codage23/projet_robocup_2024/README.md

Bonjours nous somme la Sostra-team.

Nous avons imaginé et réalisé le CuboBot dans le but de participer a un concourt nommé RoboCup.

Ce projet se divise en 6 modules soit: le Convoyeur, le Distributeur, le Portique de détection, le Bras articulé , l'afficheur Led ainsi que le module Son.
L'ensemble, est coordonné par le module Master.

Le but de ce concept est de trier des forme tel que des cubes celons leurs couleurs. 

Pour ce faire le distributeur envoie les cubes sur le convoyeur, qui les emmènent jusqu'au portique de détection de couleur.
Une fois la couleur détectée, l'information est transmise au bras, ensuite celle ci est annoncée à haute voix grâce au module son, de plus elle s'affiche sur le panneau led, tout ça dans le but de la révéler au publique.

Ceci fait le convoyeur emmène le cube jusqu'au détecteur de fin de course, placé au bout du convoyeur c'est lui qui donnera le signal au bras qu'il peut enfin venir chercher le cube et le ranger dans la boite prévue a cet effet.

La boucle recommence par le distributeur...
