codage23/projet_robocup_2024/organigramme/legende.odt

Légende :

// id 11 : moteur du convoyeur («D»emarrage «S»top)

// id 12 : IR du convoyeur («A»bsent «P»resent)

// id 13 : master

// id 14 : distributeur de cube («L»iberer)

// id 15 : IR du portique de detection de la couleur

// id 16 : detection de la couleur du cube avec le portique n°1 («R»ed «G»reen «B»lue «Y»ellow)

// id 17 : panneau d'affichage («R»ed «G»reen «B»lue «Y»ellow «E»xtinction)

// id 18 : bras articule (Red Green Blue Yellow)

// id 19 : detection de la couleur du cube avec le portique n°2 (Red Green Blue Yellow)
