codage23/projet_robocup_2024/master_modules/schema electrique master robocup 2024.pdf

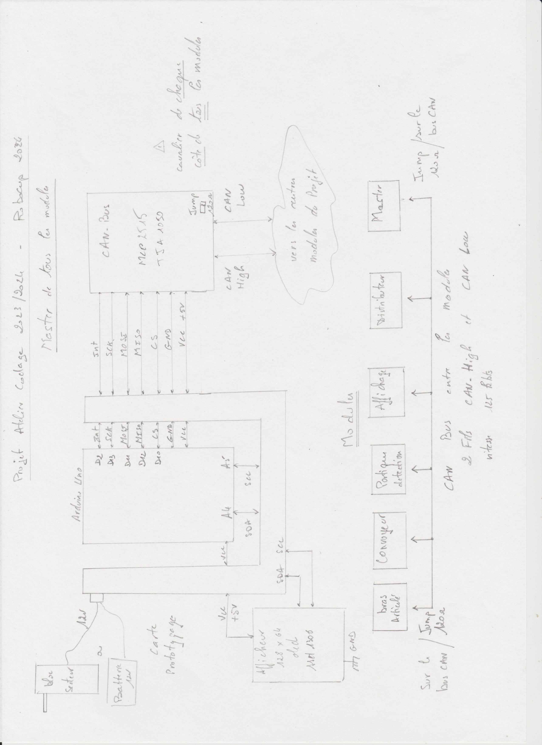
[picture p1: page 1]
