codage23/projet_robocup_2024/module_affichage/schema electrique afficheur robocup 2024.pdf

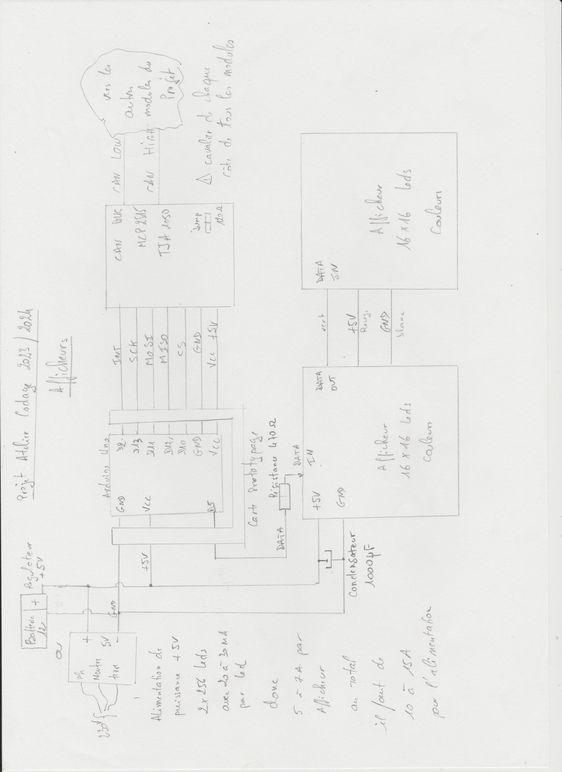
[picture p2: page 1]
