codage23/projet_robocup_2024/module_affichage/schema principe afficheur robocup 2024.pdf

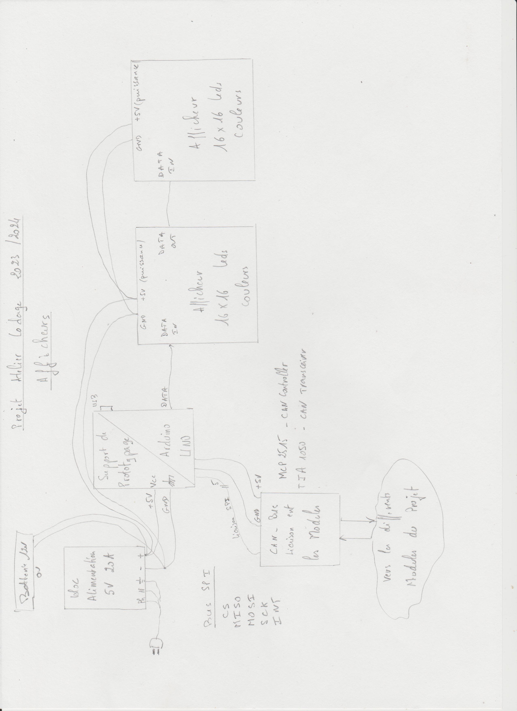
[picture p3: page 1]
