codage23/projet_robocup_2024/module_bras/schema electrique bras articule robocup 2024.pdf

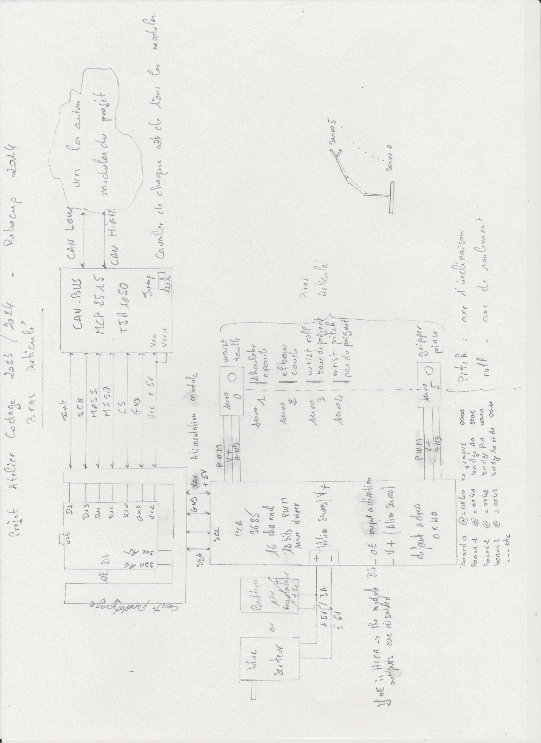
[picture p4: page 1]
