codage23/projet_robocup_2024/module_convoyeur/schema electrique convoyeur robocup 2024.pdf

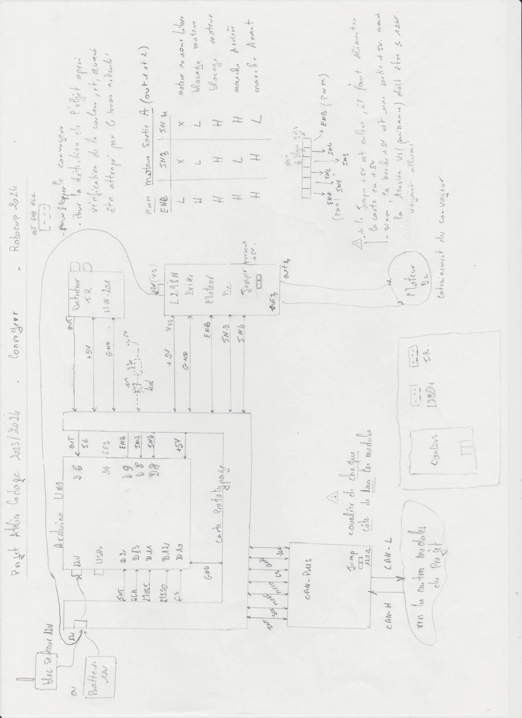
[picture p5: page 1]
