codage23/projet_robocup_2024/module_convoyeur/schema principe convoyeur robocup 2024.pdf

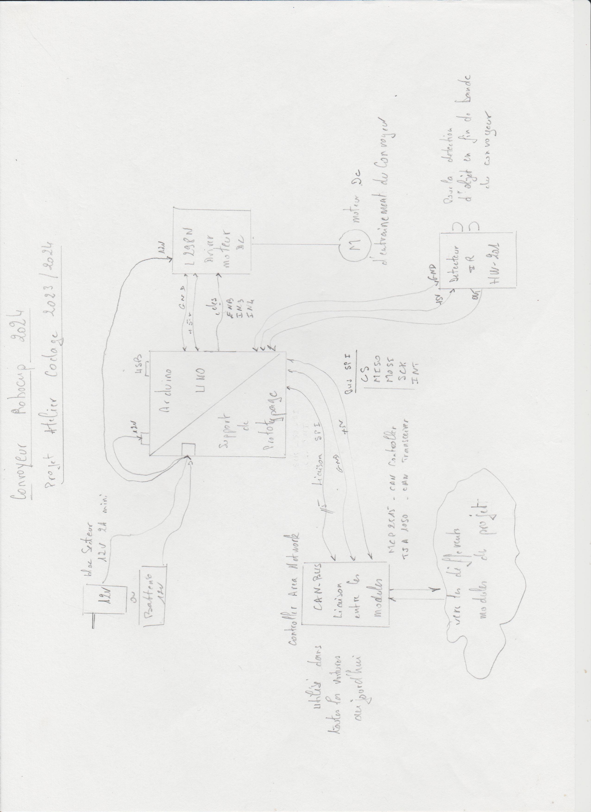
[picture p6: page 1]
