codage23/projet_robocup_2024/module_portique/schema electrique portique de detection robocup 2024.pdf

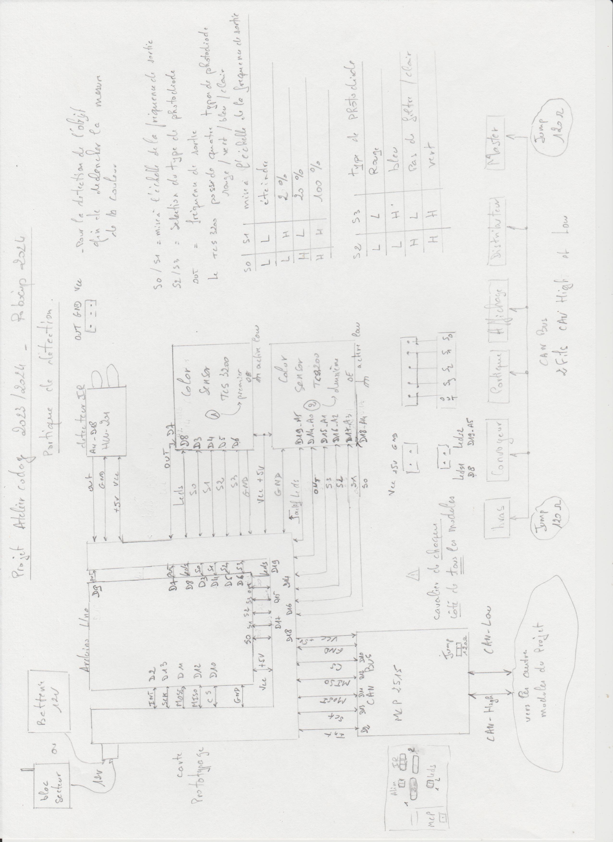
[picture p7: page 1]
