codage23/projet_robocup_2024/presentation projet/map mind projet robocup 2024 2025.pdf

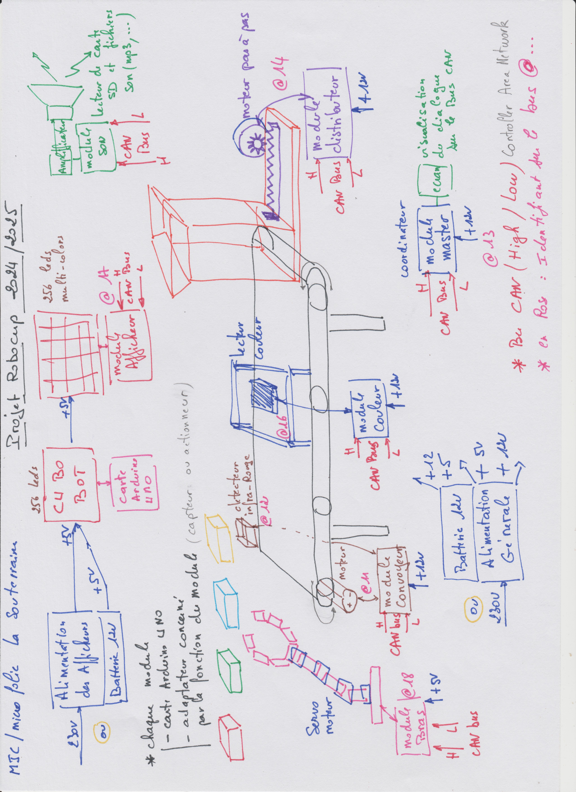
[picture p8: page 1]
