codage23/projet_robocup_2024/presentation projet/carte mentale.pdf

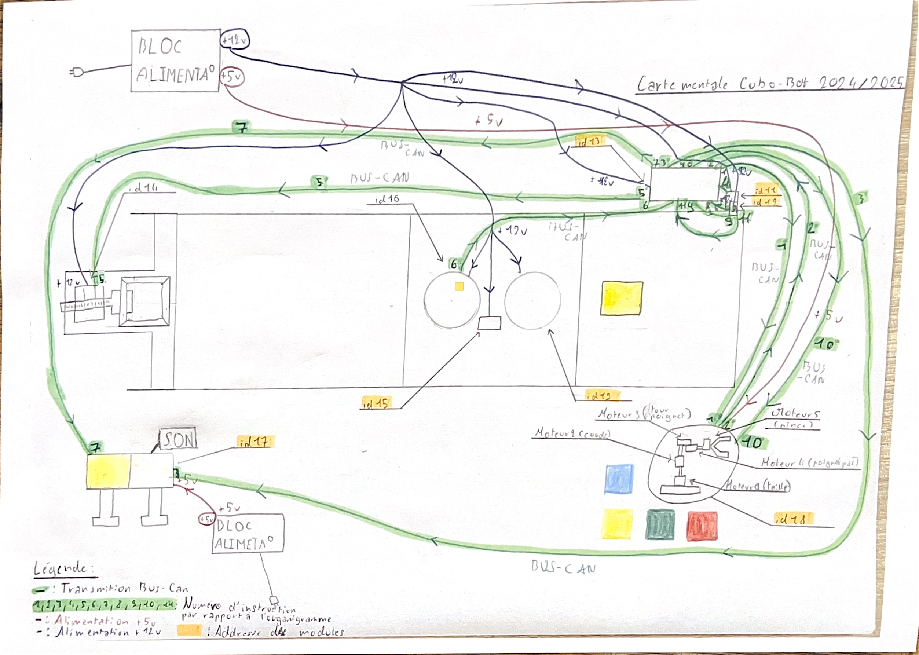
[picture p9: page 1]
