codage23/projet_robocup_2024/organigramme/organigramme.pdf

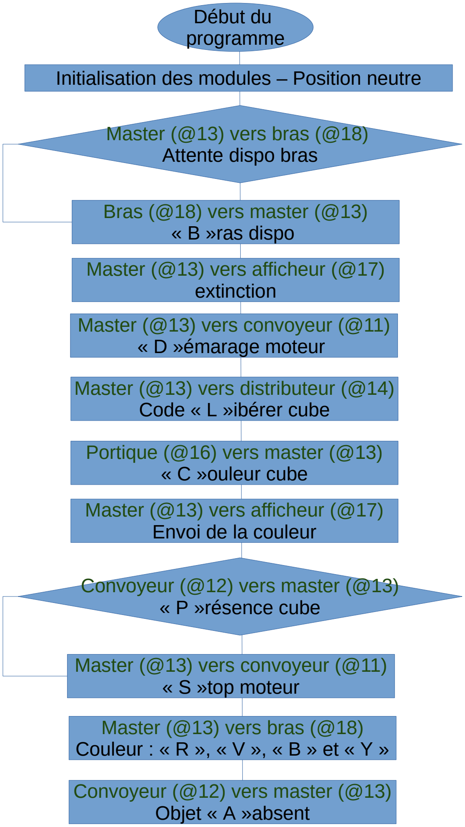
[picture p10: figure]
Début du programme; Bras (@18) vers master (@13) « B »ras dispo; Master (@13) vers distributeur (@14) Code « L »ibérer cube; Portique (@16) vers master (@13) « C »ouleur cube; Convoyeur (@12) vers master (@13) « P »résence cube; Master (@13) vers convoyeur (@11) « S »top moteur; Master (@13) vers afficheur (@17) extinction; Master (@13) vers bras (@18) Couleur : « R », « V », « B » et « Y »; Master (@13) vers convoyeur (@11) « D »émarage moteur; Convoyeur (@12) vers master (@13) Objet « A »absent; Master (@13) vers bras (@18) Attente dispo bras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

Initialisation des modules – Position neutre
