codage23/projet_robocup_2024/module_distributeur/schema electrique distributeur avec stepper.pdf

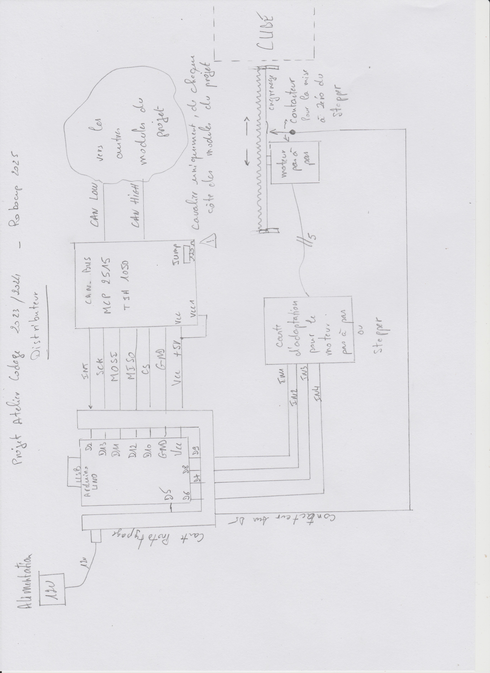
[picture p11: page 1]
