codage23/projet_robocup_2024/module_distributeur/schema principe distributeur avec stepper.pdf

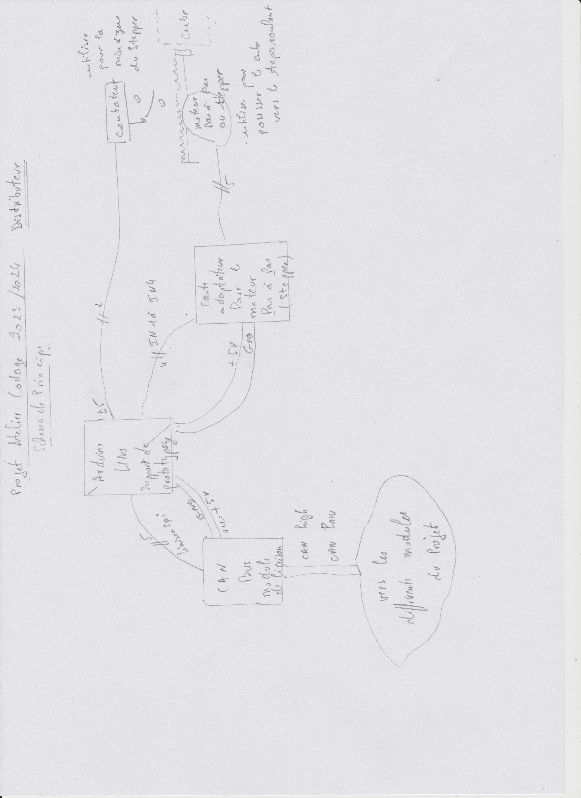
[picture p12: page 1]
