codage23/projet_robocup_2024/module_distributeur/robocup 2024 schema electrique module distributeur.pdf

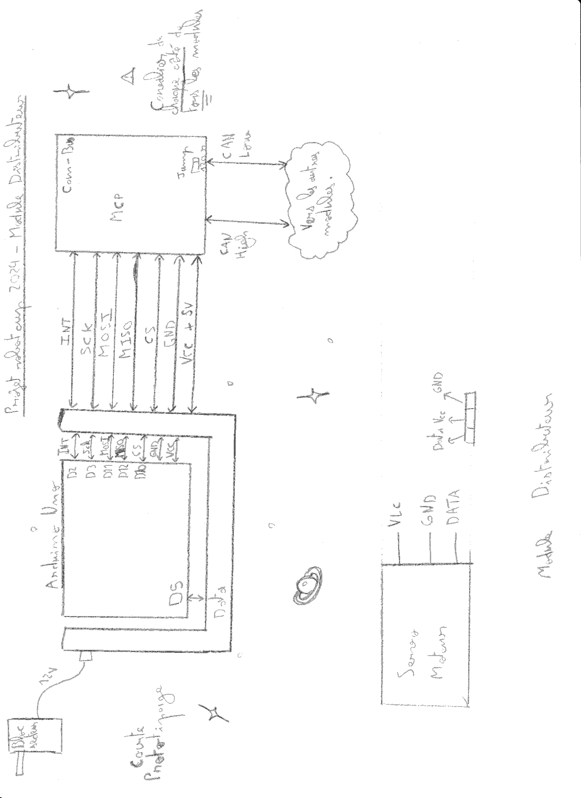
[picture p13: page 1]
