codage23/projet_robocup_2024/module_portique/schema principe portique de detection robocup 2024.pdf

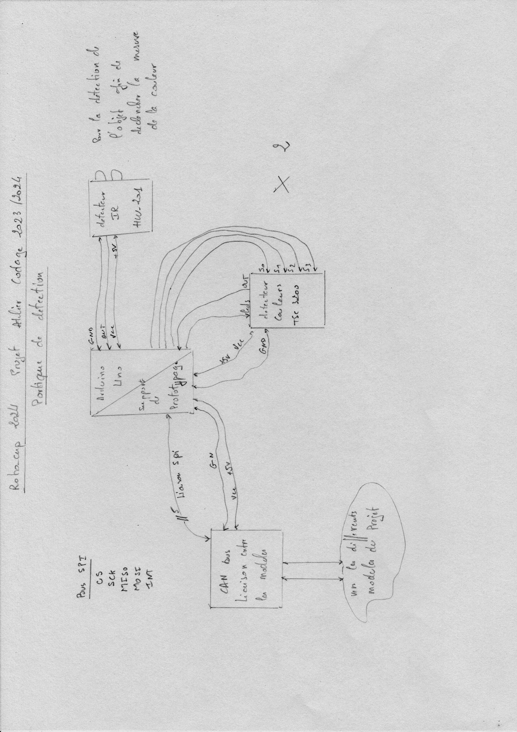
[picture p14: page 1]
