codage23/projet_robocup_2024/module_son/Schematic_Son_cubobot_2025-01-29.pdf

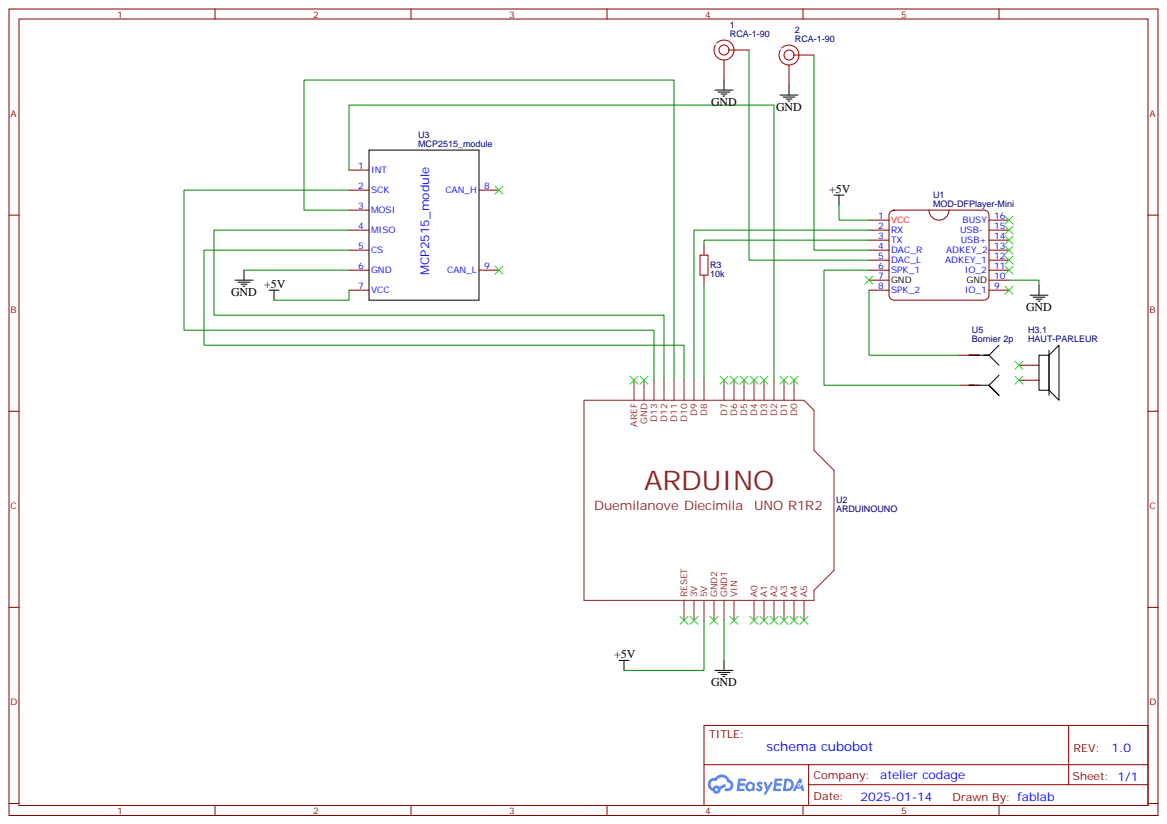
[picture p15: page 1]

MOD-DFPlayer-Mini
GND 10 IO_2 11 ADKEY_1 12 ADKEY_2 13 USB+ 14 USB- 15 BUSY 16
