codage23/projet_robocup_2024/module_convoyeur/convoyeur_arduino/convoyeur_arduino.ino

/***************************************************************
    projet robocup 2024
    convoyeur
    mjc fablab atelier codage 2023 2024
    https://passionelectronique.fr/tutoriel-l298n/
    https://tutorial45.com/mcp2515-arduino-project-can-arduino/
    https://github.com/sandeepmistry/arduino-CAN/tree/master
***************************************************************/

//=============================
// inclusion des bibliothèques
//=============================
#include <SPI.h>  // pour la bibliothèque CAN
#include <CAN.h>
#include "variables.h"  // fichier variables

//======================
// sensor IR infra rouge
//======================
bool sensorIR() {
  bool sensorStatus = digitalRead(IRSensor);  // read IRsensor
  return sensorStatus;
}

//======
// setup
//======
void setup() {
  Serial.begin(SERIAL_BAUD);
  Serial.println();
  Serial.println("Demarrage du convoyeur avec le sensor ir");

  // Configuration des pins de l'Arduino en "sortie" pour le shield L298N - gestion du moteur
  pinMode(borneENB, OUTPUT);
  pinMode(borneIN3, OUTPUT);
  pinMode(borneIN4, OUTPUT);

  // sensor ir infra rouge
  pinMode(IRSensor, INPUT);  // IR Sensor pin INPUT
  pinMode(LED, OUTPUT);      // LED Pin Output

  // start the CAN bus at 125 kbps
  if (!CAN.begin(125E3)) {
    Serial.println("Starting CAN failed!");
    while (1)
      ;
  }

  // register the receive callback - interruption des l'arrivee d'un message sur le bus can
  CAN.onReceive(onReceive);
}

//=========================================
// Fonction configurerSensDeRotationPontB()
// Definit le sens de rotation du moteur
//=========================================
void configurerSensDeRotationPontB(bool sensDeRotation) {
  if (sensDeRotation == MARCHE_AVANT) {
    // L298N en "marche avant", Selon sa table de verite
    digitalWrite(borneIN3, HIGH);  // IN3 niveau haut
    digitalWrite(borneIN4, LOW);   // IN4 niveau bas
  }
  if (sensDeRotation == MARCHE_ARRIERE) {
    // L298N en "marche avant", Selon sa table de verite
    digitalWrite(borneIN3, LOW);   // IN3 niveau bas
    digitalWrite(borneIN4, HIGH);  // IN4 niveau haut
  }
}

//=========================================================================
// Fonction changeVitesseMoteurPontB()
// Change la vitesse de rotation du moteur (valeur comprise entre 0 et 255)
//=========================================================================
void changeVitesseMoteurPontB(int nouvelleVitesse) {
  // signal PWM rapport cyclique "nouvelleVitesse"
  analogWrite(borneENB, nouvelleVitesse);
}

//==========================
//  CAN reception suite irq
//==========================
void onReceive(int packetSize) {
  while (CAN.available()) {
    caractere = (char)CAN.read();  // lecture du bus can dans la variable caractere
    id = CAN.packetId();           // id du message can  dans la variable id
  }
}

//======
// loop
//======
void loop() {
//====================================
// convoyeur avec CAN bus et le master
//====================================
#if CANBUS
  // demarrage progessif - une seule fois
  if (marche) {
    configurerSensDeRotationPontB(MARCHE_AVANT);  //sens de rotation du moteur en "marche avant"
    // depart progresif du moteur, vitesse maxi 255
    for (vitesse = vitesseMinimale; vitesse < vitesseMaximale; vitesse++) {
      changeVitesseMoteurPontB(vitesse);  // vitesse moteur avec signal PWM
      delay(delaiChangementVitesse);
    }
    marche = 0;  // pour avoir un seul demarrage progessif
  }

  // test la presence d'un objet avec le detecteur ir
  if ((sensorIR() == 0) and (presentAbsent == 0)) {  // objet present
    digitalWrite(LED, HIGH);                         // LED High
    presentAbsent = 1;                               // objet present
    CAN.beginPacket(0x12);                           // id 0x12 pour le detecteur ir du convoyeur
    CAN.write('P');                                  // envoi objet present P
    CAN.endPacket();                                 // envoi sur le bus can
    if (debug) {
      Serial.println("Sending packet objet present");
    }
  }

  if ((sensorIR() == 1) and (presentAbsent == 1)) {  // objet absent
    digitalWrite(LED, LOW);                          // LED LOW
    presentAbsent = 0;                               // objet absent
    CAN.beginPacket(0x12);                           // id 0x12 pour le detecteur ir du convoyeur
    CAN.write('A');                                  // envoi objet absent A
    CAN.endPacket();                                 // envoi sur le bus can
    if (debug) {
      Serial.println("Sending packet objet absent");
    }
  }

  if (caractere == 'S' and id == 0x11) {         // reception commande S du master id 0x11
    changeVitesseMoteurPontB(0);                 // arret moteur - vitesse nul
    caractere = '0';                             // effacement du caratere apres lecture
    id = 0x0;                                    // effacement de la variable id apres lecture
  }
  if (caractere == 'D' and id == 0x11) {         // reception commande D du master  id 0x11
    marche = 1;                                  // pour valider un nouveau demarrage car l'objet n'est plus present
    caractere = '0';                             // effacement du caratere apres lecture
    id = 0x0;                                    // effacement de la variable id apres lecture
  }
#endif

//====================================
// convoyeur autonome - sans le master
//====================================
#if AUTONOME
  // demarrage progessif du moteur une seule fois
  if (marche) {
    //sens de rotation du moteur en "marche avant"
    configurerSensDeRotationPontB(MARCHE_AVANT);
    // depart progresif du moteur, vitesse maxi 255
    for (vitesse = vitesseMinimale; vitesse < vitesseMaximale; vitesse++) {
      changeVitesseMoteurPontB(vitesse);  // vitesse moteur avec signal PWM
      delay(delaiChangementVitesse);
    }
    marche = 0;  // pour avoir un seul demarrage progessif
  }
  // Check if the pin high or not IRsensor
  if (sensorIR() == 1) {      // objet absent
    digitalWrite(LED, LOW);   // LED LOW
    if (objetPresent == 1) {  //  pour valider un nouveau demarrage des que l'objet n'est plus present
      marche = 1;
    }
    objetPresent = 0;  // pas d'objet 0
    if (debug) {
      Serial.println("objet absent");
    }
  }
  if (sensorIR() == 0) {      // objet present
    digitalWrite(LED, HIGH);  // LED High
    // arret moteur
    changeVitesseMoteurPontB(0);  // vitesse nul
    objetPresent = 1;             // objet present 1
    if (debug) {
      Serial.println("objet present");
    }
  }
#endif

//====================================
// convoyeur test - sans le master
//====================================
#if TEST
  //avant
  //sens de rotation du moteur en "marche avant"
  configurerSensDeRotationPontB(MARCHE_AVANT);
  // depart progresif du moteur, vitesse maxi 255
  for (vitesse = vitesseMinimale; vitesse < vitesseMaximale; vitesse++) {
    changeVitesseMoteurPontB(vitesse);  // vitesse moteur avec signal PWM
    delay(delaiChangementVitesse);
  }
  delay(10000);
  // deceleration progressive
  for (vitesse = vitesseMaximale; vitesse > vitesseMinimale; vitesse--) {
    changeVitesseMoteurPontB(vitesse);  // vitesse moteur avec signal PWM
    delay(delaiChangementVitesse);
  }
  // arret moteur
  changeVitesseMoteurPontB(0);
  delay(1000);
  //arriere
  //sens de rotation du moteur en "marche arriere"
  configurerSensDeRotationPontB(MARCHE_ARRIERE);
  //depart progresif du moteur, vitesse maxi 255
  for (vitesse = vitesseMinimale; vitesse < vitesseMaximale; vitesse++) {
    changeVitesseMoteurPontB(vitesse);  // vitesse moteur avec signal PWM
    delay(delaiChangementVitesse);
  }
  delay(10000);
  // deceleration progressive
  for (vitesse = vitesseMaximale; vitesse > vitesseMinimale; vitesse--) {
    changeVitesseMoteurPontB(vitesse);  // vitesse moteur avec signal PWM
    delay(delaiChangementVitesse);
  }
  // arret moteur
  changeVitesseMoteurPontB(0);
  delay(1000);
#endif
}
