codage23/projet_robocup_2024/(commit log)

2023-12-15 programme convoyeur propre et master seulement la partie convoyeur
2024-01-24 module portique pour la detection de couleurs
2024-02-07 master et portique , ajout de nouvelles fonctions
2024-03-16 mise à jour du deplacement du bras et ajout du servo moteur pour le distributeur
2024-03-19 debut reglage des servos du bras
2024-03-24 distributeur avec servotimer2 et milli - bras avec reglages de chaque servo
2024-03-26 module afficheur prise en compte des couleurs et affichage de la couleur sur les deux panneaux
2024-03-28 reglages disstributeur temps de fonctionnement du servo
2024-03-28 module afficheurs , la memoire de l'arduino est faible donc utilise 256 leds seulement ou enlever toutes l'utilisation de debug
2024-07-23 simplification du programme pour le bras articule - ne pas repeter les commandes pour des valeurs de servo moteur identiques
2024-08-14 deplacement du bras de 90 degres
2024-09-25 petites corrections du master
    [arduino_master_can_bus.ino]
2024-10-02 modification du module distributeur, avec bibliotheque servo
2024-10-10 modification du bras et du master pour le dialogue entre les deux
2025-01-22 affichage des couleurs
2025-03-08 reglage du stepper avec library accelstepper
2025-03-09 schemas du distributeur avec stepper
2025-03-12 module son arduino uno
2025-03-26 seance du 20250325 , modification programme son et distributeur stepper
2025-05-20 remplacement des alimentations par deux batteries 12volts
